mswietlicki/catinhaler/docs/img/pl/chamber_section_labeled.png

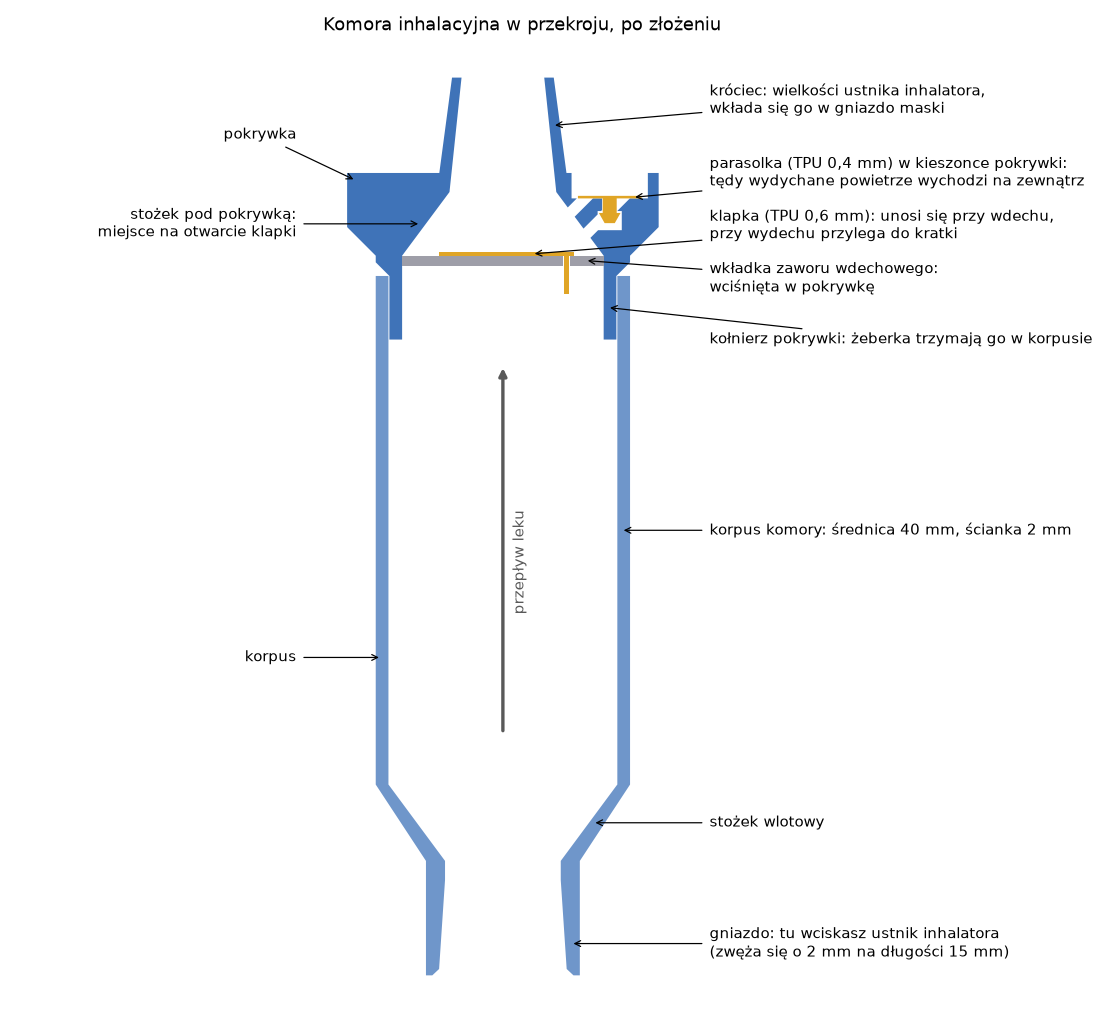
docs/img/pl/chamber_section_labeled.png
