mswietlicki/catinhaler/docs/img/pl/mask_orientation.png

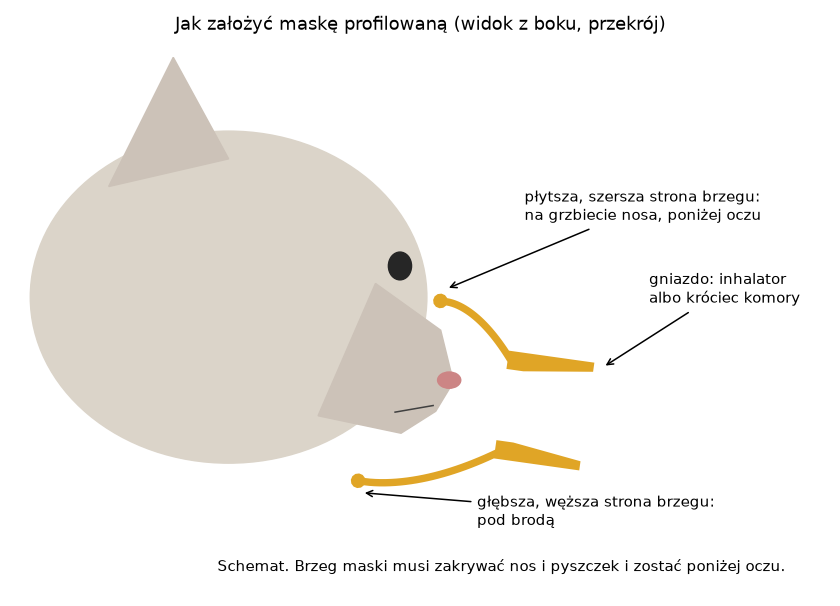
docs/img/pl/mask_orientation.png
