mswietlicki/catinhaler/stl/3.3kg/round_cushion_inhaler_mask_3.3kg.stl

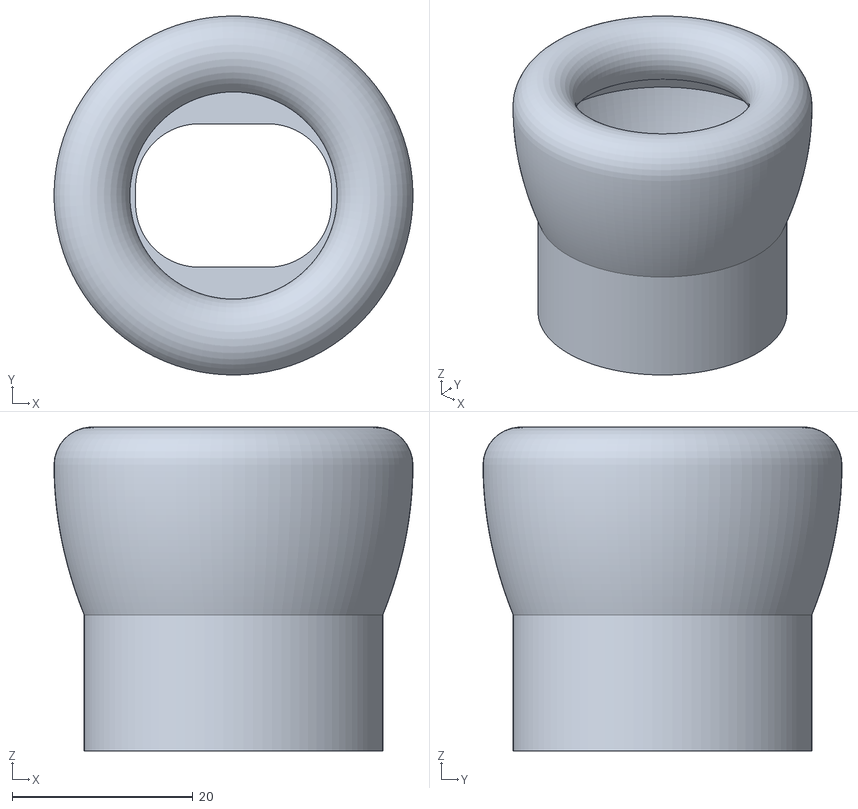
[picture p5: CAD file, 2026-10-13]
stl/3.3kg/round_cushion_inhaler_mask_3.3kg.stl
39.7 x 39.7 x 35.8
