mswietlicki/catinhaler/stl/4kg/round_cushion_inhaler_mask_4kg.stl

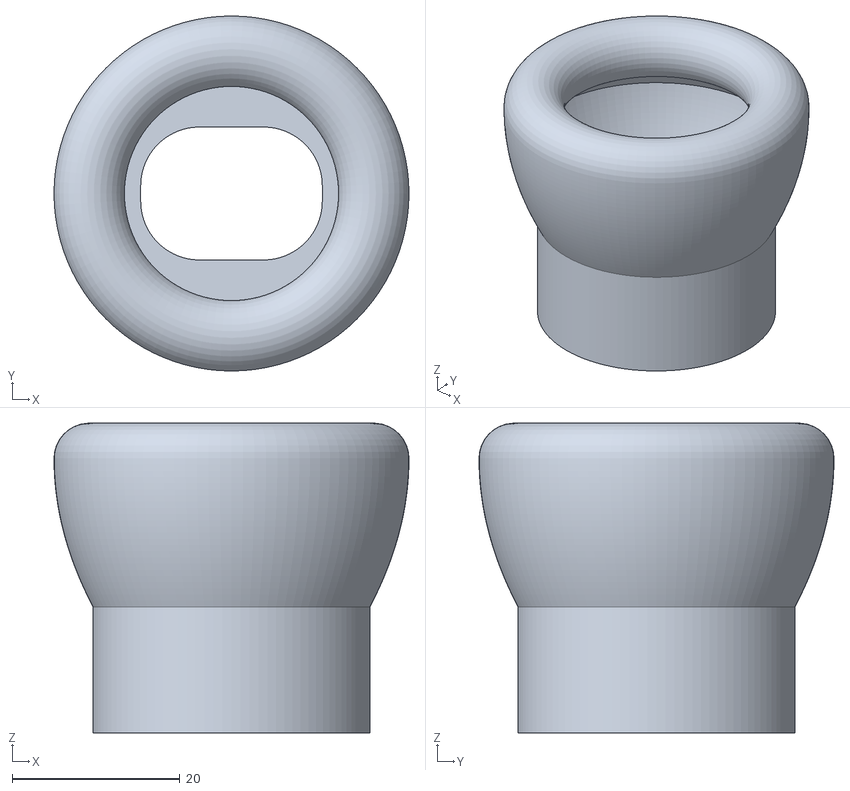
[picture p6: CAD file, 2026-10-13]
stl/4kg/round_cushion_inhaler_mask_4kg.stl
42.3 x 42.3 x 36.9
