mswietlicki/catinhaler/stl/5kg/cat_face_inhaler_mask_5kg.stl

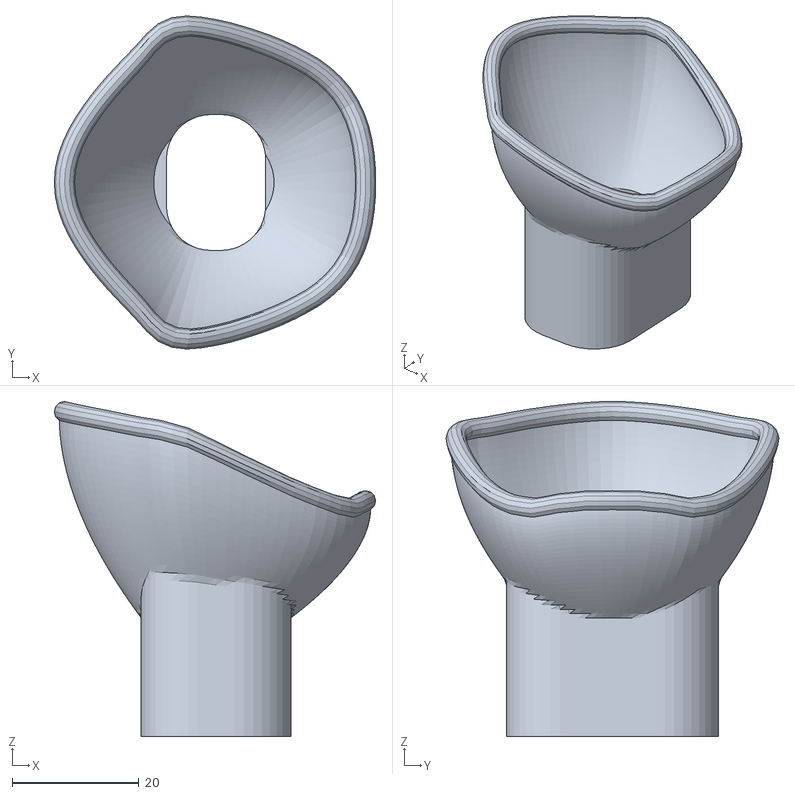
[picture p7: CAD file, 2026-10-13]
stl/5kg/cat_face_inhaler_mask_5kg.stl
50.7 x 52.5 x 52.8
