mswietlicki/catinhaler/stl/6kg/round_cushion_inhaler_mask_6kg.stl

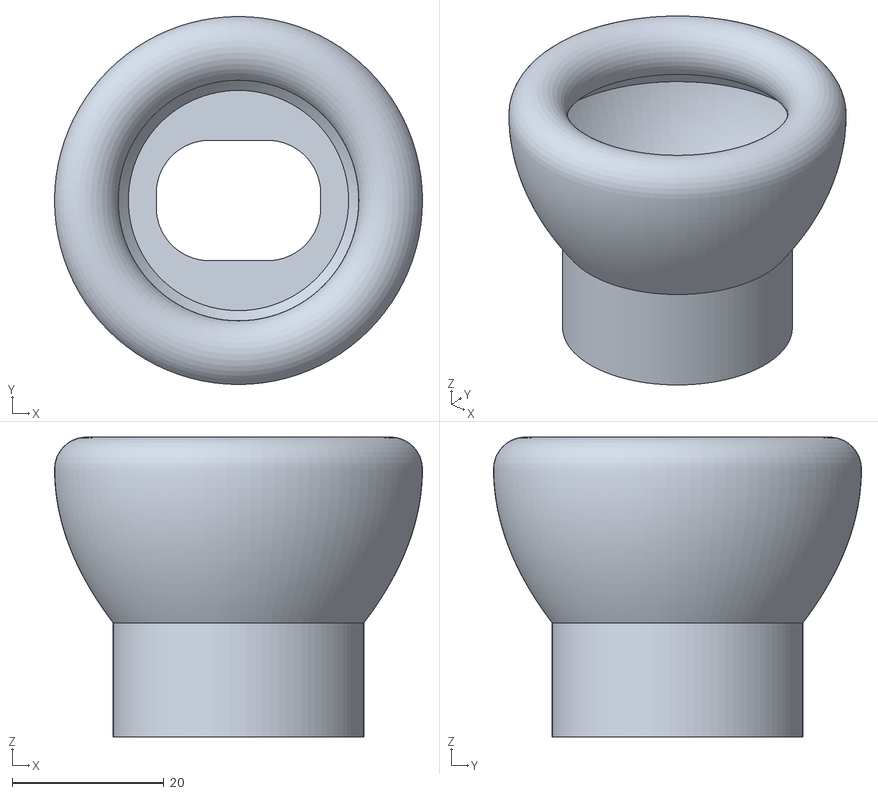
[picture p8: CAD file, 2026-10-13]
stl/6kg/round_cushion_inhaler_mask_6kg.stl
48.4 x 48.4 x 39.4
