mswietlicki/catinhaler/stl/common/holding_chamber_body.stl

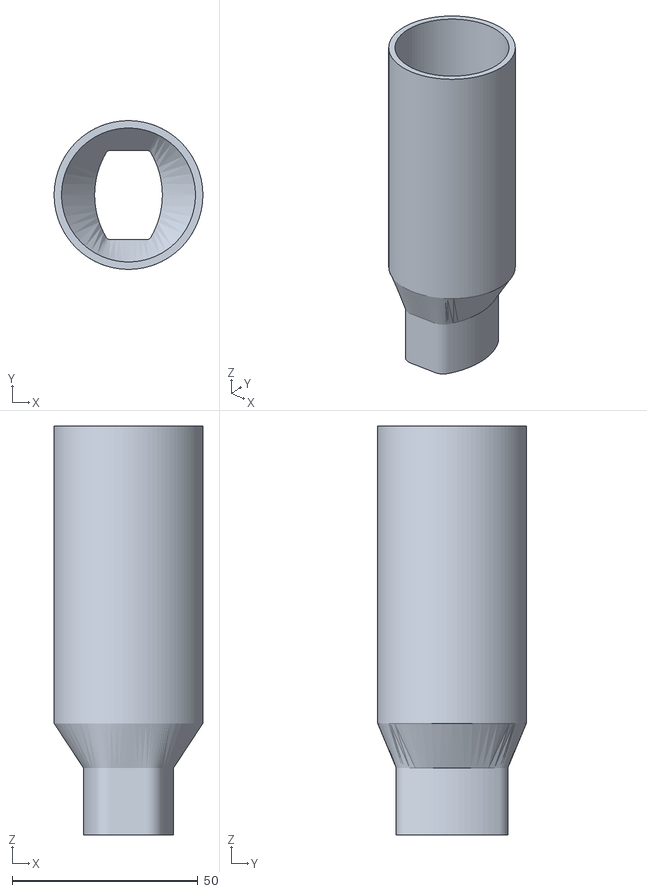
[picture p9: CAD file, 2026-10-14]
stl/common/holding_chamber_body.stl
40.0 x 40.0 x 110.0
