mswietlicki/catinhaler/stl/3.3kg/cat_face_inhaler_mask_3.3kg.stl

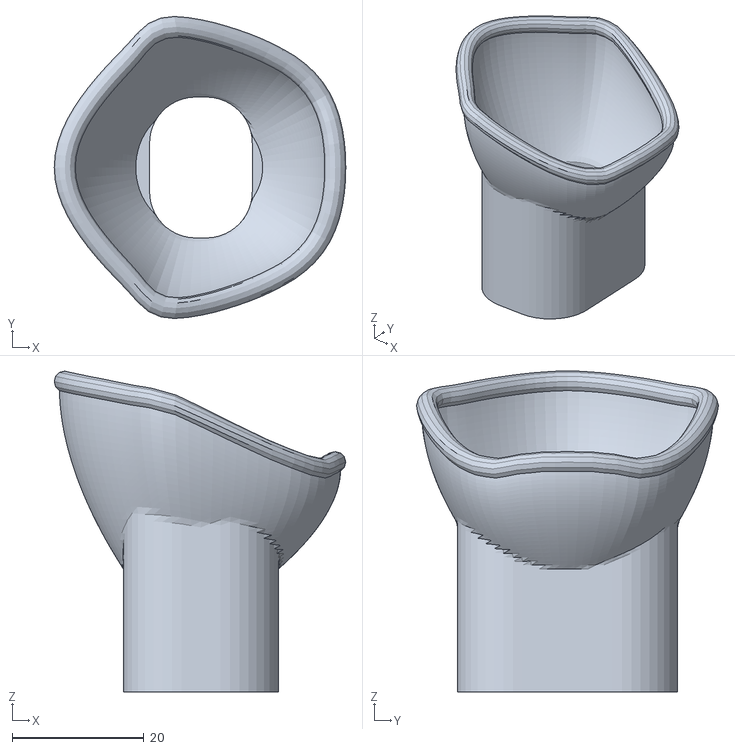
[picture p10: CAD file, 2026-10-13]
stl/3.3kg/cat_face_inhaler_mask_3.3kg.stl
44.3 x 45.9 x 48.8
