mswietlicki/catinhaler/stl/4kg/cat_face_inhaler_mask_4kg.stl

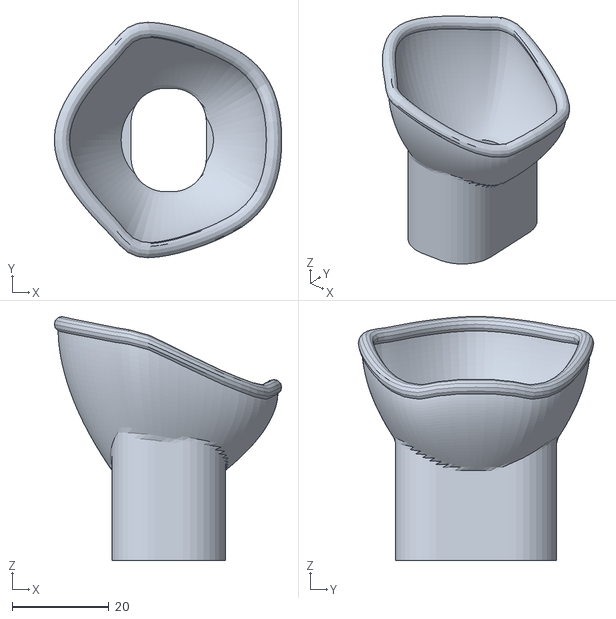
[picture p11: CAD file, 2026-10-13]
stl/4kg/cat_face_inhaler_mask_4kg.stl
47.1 x 48.8 x 50.6
