mswietlicki/catinhaler/stl/5kg/round_cushion_inhaler_mask_5kg.stl

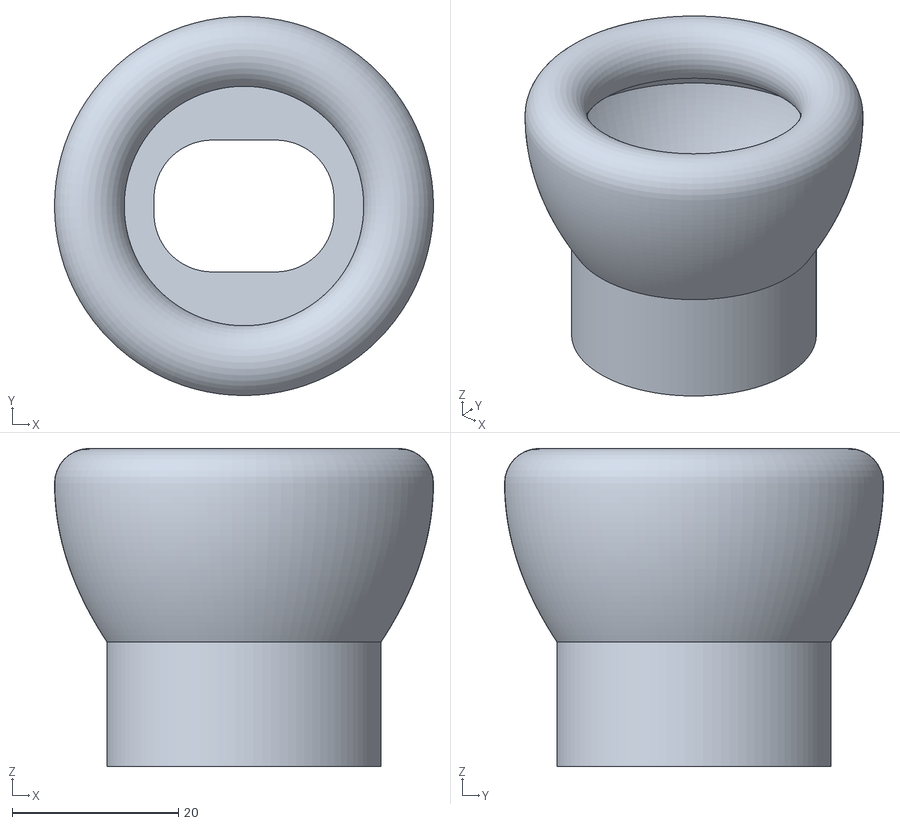
[picture p12: CAD file, 2026-10-13]
stl/5kg/round_cushion_inhaler_mask_5kg.stl
45.6 x 45.6 x 38.3
