mswietlicki/catinhaler/stl/6kg/cat_face_inhaler_mask_6kg.stl

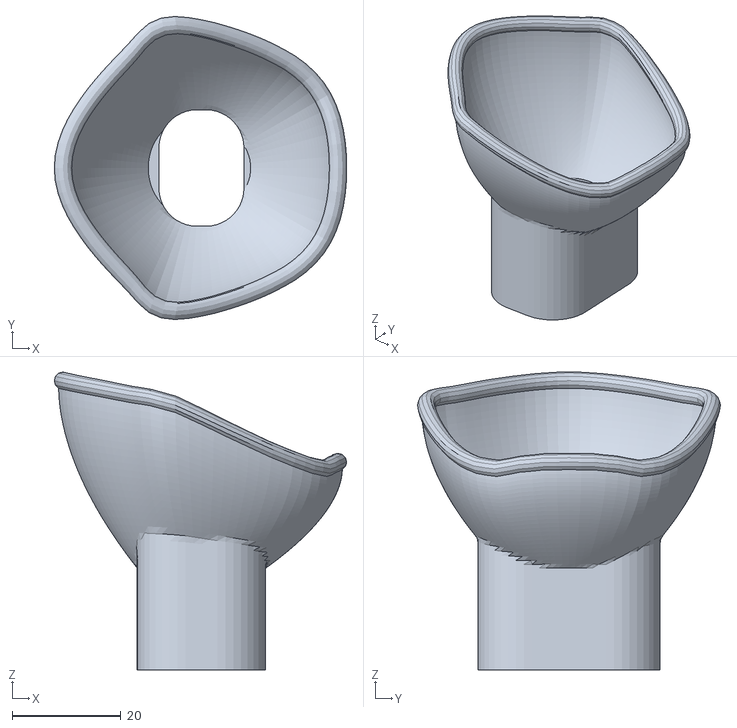
[picture p13: CAD file, 2026-10-13]
stl/6kg/cat_face_inhaler_mask_6kg.stl
53.7 x 55.7 x 54.7
