mswietlicki/catinhaler/stl/common/holding_chamber_socket_test.stl

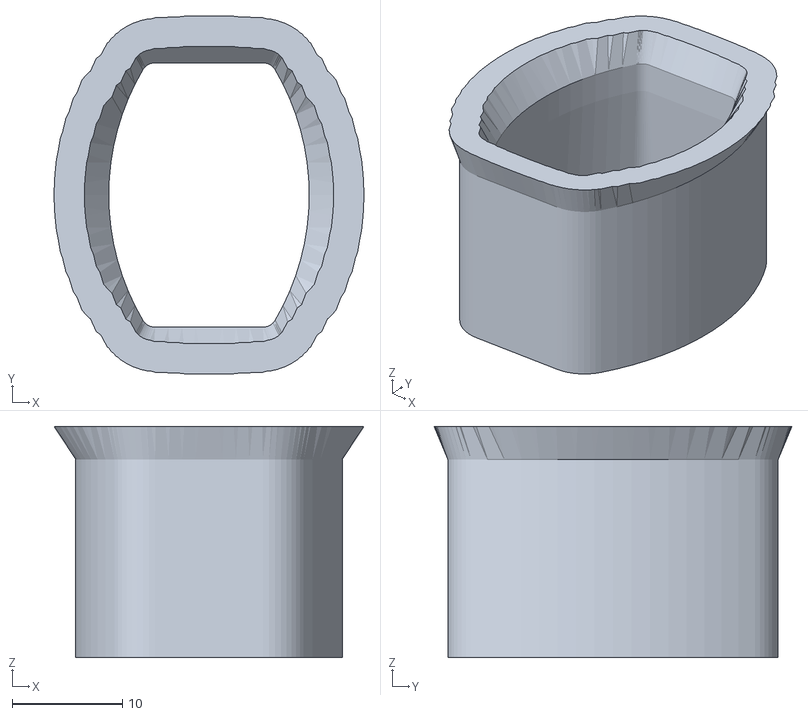
[picture p14: CAD file, 2026-10-14]
stl/common/holding_chamber_socket_test.stl
28.1 x 32.5 x 21.0
