mswietlicki/catinhaler/stl/common/holding_chamber_one_piece_spacer.stl

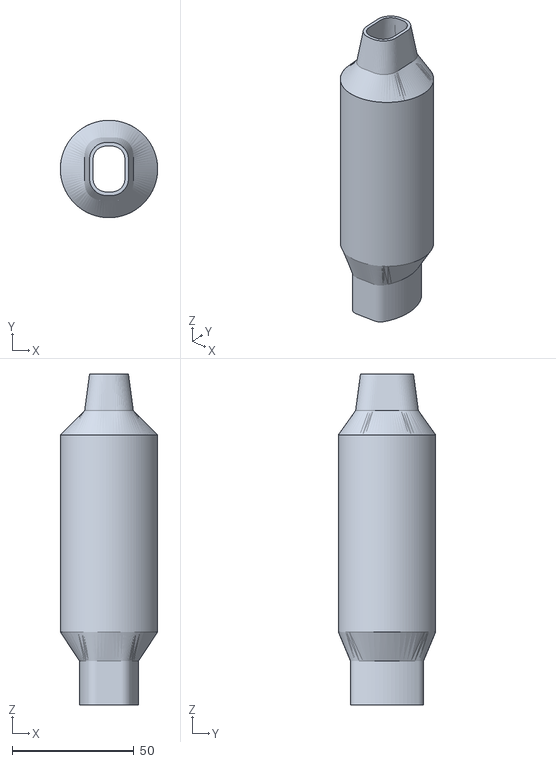
[picture p15: CAD file, 2026-10-14]
stl/common/holding_chamber_one_piece_spacer.stl
40.0 x 40.0 x 136.0
