mswietlicki/catinhaler/stl/common/holding_chamber_cap.stl

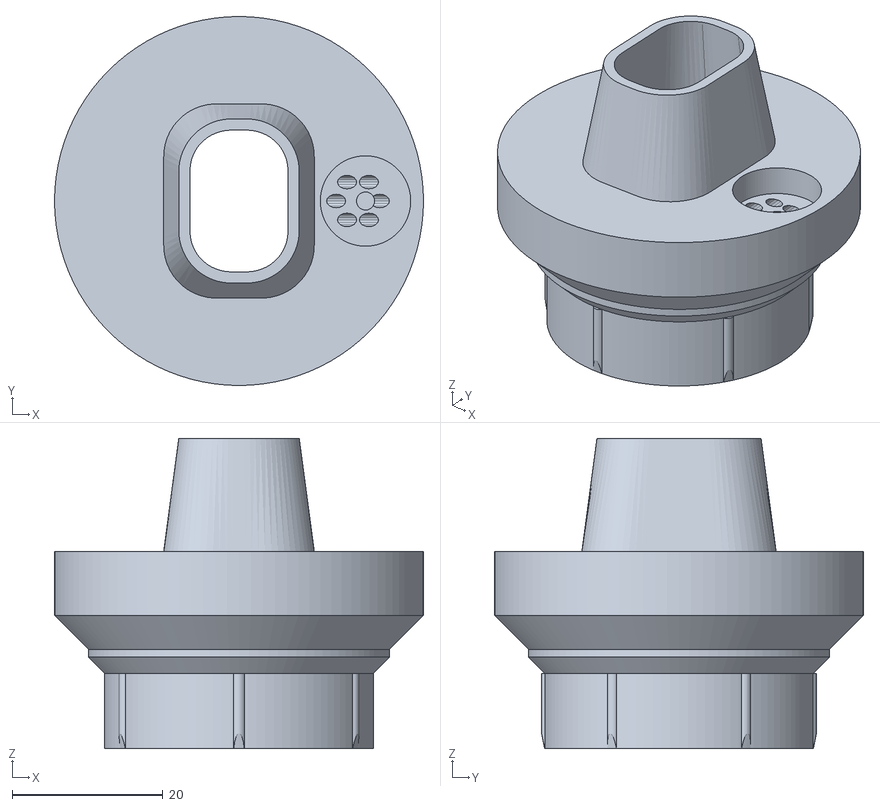
[picture p16: CAD file, 2026-10-13]
stl/common/holding_chamber_cap.stl
49.0 x 49.0 x 41.2
