mswietlicki/catinhaler/stl/common/holding_chamber_valve_flap.stl

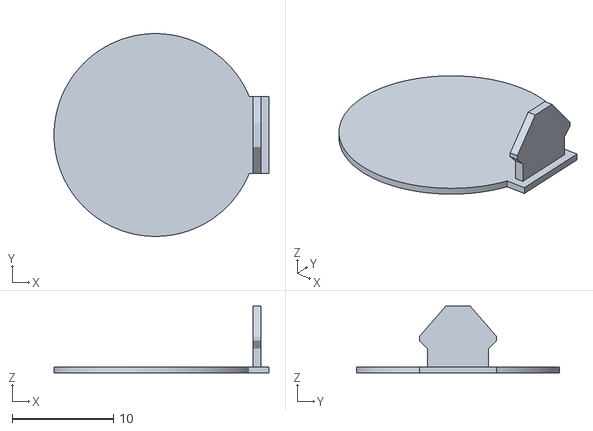
[picture p17: CAD file, 2026-10-13]
stl/common/holding_chamber_valve_flap.stl
21.2 x 20.0 x 6.60
