mswietlicki/catinhaler/stl/common/holding_chamber_valve_insert.stl

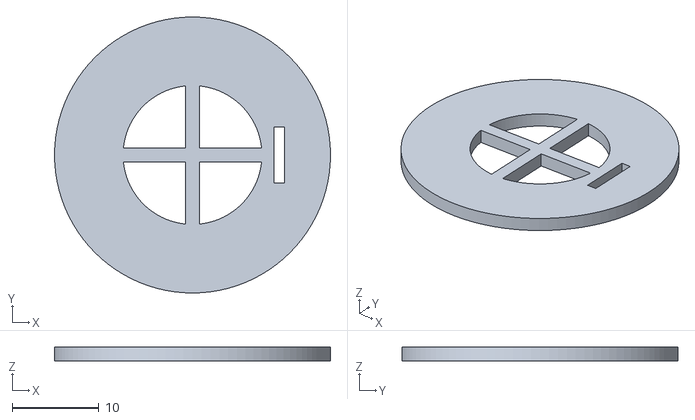
[picture p18: CAD file, 2026-10-13]
stl/common/holding_chamber_valve_insert.stl
31.8 x 31.8 x 1.60
