mswietlicki/catinhaler/stl/common/holding_chamber_umbrella.stl

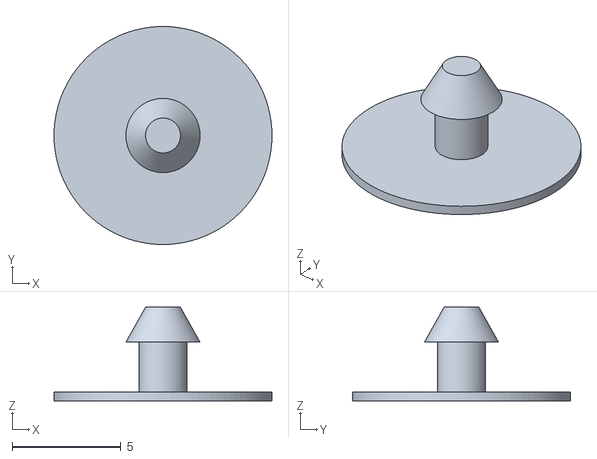
[picture p19: CAD file, 2026-10-13]
stl/common/holding_chamber_umbrella.stl
10.0 x 10.0 x 4.29
