mswietlicki/catinhaler/docs/img/pl/valve_assembly.png

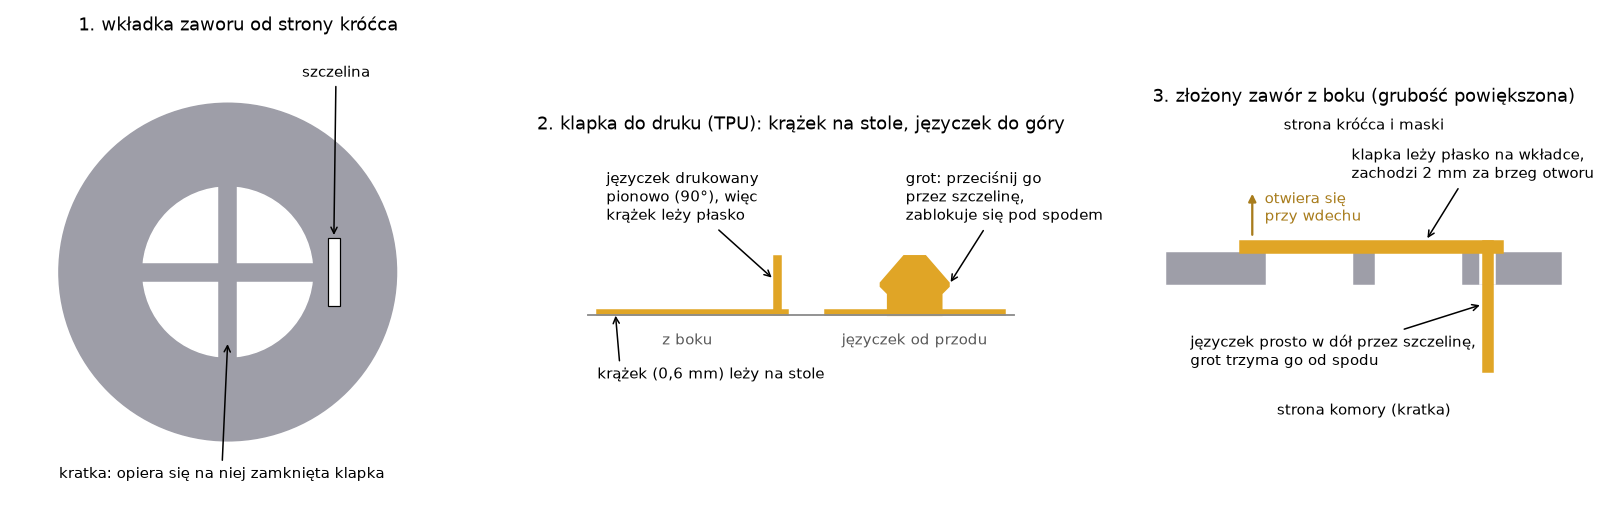
docs/img/pl/valve_assembly.png
