mswietlicki/catinhaler/(commit log)

2026-10-13 Export masks for 3.3, 4, 5 and 6 kg cats; move chamber parts to stl/common
    Cat faces differ in size, so a single 3.3 kg mask does not fit every cat.
    scripts/render.py now exports both masks and the cat face rim paper template
    for every weight in its SIZES list into stl/<weight>kg/, with the size in each
    file name so the parts stay identifiable in a slicer. The holding chamber
    parts do not depend on the cat's size (every mask has the same inhaler
    socket) and move to stl/common/. The 3.3 kg masks and the chamber parts are
    geometrically identical to the previous exports.
    - The paper template is labelled with the cat weight it was made for.
    - New docs/img/mask_sizes.png compares all eight masks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
    [cat_face_inhaler_mask.scad, cat_face_inhaler_mask_3.3kg.stl, cat_face_inhaler_mask_4kg.stl, cat_face_inhaler_mask_5kg.stl, cat_face_inhaler_mask_6kg.stl, holding_chamber_body.stl, holding_chamber_cap.stl, holding_chamber_one_piece_spacer.stl]
2026-10-13 Add a Polish website for cat owners, published with GitHub Pages
    The README and manual are written for makers. Owners of a cat that needs an
    inhaler often are not, so site/ adds a Polish website that walks them through
    it in plain language: what the kit is and how it works, choosing the size
    with printable paper templates, one ZIP download per cat size, printing or
    ordering a print (with a ready-to-send message for a print service),
    assembly with pictures, getting the cat used to the mask, giving the
    medicine, cleaning and an FAQ.
    - scripts/build_site.py builds _site/ from site/, docs/img/ and stl/ with the
    Python standard library only: files are renamed after their material
    (TPU_..., P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
    [cat_face_inhaler_mask.scad, holding_chamber.scad, round_cushion_inhaler_mask.scad]
2026-10-13 Fix loose cap, flap that lifts, and loose nozzle after the first print
    - Cap skirt: add 6 crush ribs (skirt_rib_interference = 0.25 mm) with a
    2 mm lead-in. With a plain 0.15 mm clearance the PETG cap fell out of
    the body; the ribs grip whatever the printer's tolerance.
    - Flap: print the hinge tab standing up from the disc edge (L-shape,
    0.8 mm thick, 45 deg barb instead of the round bulb). A TPU tab printed
    flat springs back after being bent through the slot and lifts the disc.
    The insert slot follows the tab thickness (1.0 -> 1.2 mm).
    - Nozzle: nozzle_oversize 0 -> 0.4 so it stretches the TPU mask socket;
    head_d 48 -> 49 to keep room for the exhalation pocket.
    - Diagrams draw t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
    [holding_chamber.scad, holding_chamber_cap.stl, holding_chamber_one_piece_spacer.stl, holding_chamber_valve_flap.stl, holding_chamber_valve_insert.stl]
2026-10-14 Fit the chamber's inhaler socket to the real Ventolin mouthpiece
    The PETG chamber body did not take the inhaler easily. Its socket was the
    same rounded rectangle (7 mm corners, 4 mm wedge) as the TPU masks: the
    round corners cut into the mouthpiece's corners, and a 4 mm wedge only
    works in a material that stretches.
    The Ventolin HFA mouthpiece is a "barrel": straight short ends, long
    sides that bulge outwards, small corners. The socket now follows that
    outline, fitted to two published sockets made for a Ventolin (city17's
    Printables 848067 bottle adapter, bens' NIH 3DPX-018151 vase spacer)
    and to photos of the mouthpiece and its cap: 25.4 x 19.6 mm, 12 mm high
    next to the corners, 2 mm corn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
    [holding_chamber.scad, holding_chamber_body.stl, holding_chamber_one_piece_spacer.stl, holding_chamber_socket_test.stl]
